freeDSP/freeDSPx-AMP-x4/PARTLIST/basket_mouser.xls

WARENKORB
Dies ist keine Rechnung
Dez 06, 2016 14:13:36
 | Mouser-Nr. | Herst.- Nr. | Hersteller | Kundennummer | Beschreibung | RoHS | Lebenszyklus | Stückzahl | Preis (EUR) | Durchw.: (EUR)
1 | 667-EEU-FC1V101 | EEU-FC1V101 | Panasonic |  | Alu-Elektrolytkondensatoren - verdrahtet 100uF 35V | RoHS-konform |  | 8 | 0,453 € | 3,62 €
2 | 81-GRM18R71E223KA01J | GRM188R71E223KA01J | Murata |  | Kondensator aus mehreren Keramikschichten MLCC - SMD/SMT 0603 0.022uF 25volts X7R 10% | RoHS-konform |  | 8 | 0,094 € | 0,75 €
3 | 81-GCM31CR71H684KA7L | GCM31CR71H684KA37L | Murata |  | Kondensator aus mehreren Keramikschichten MLCC - SMD/SMT 1206 0.68uF 50volts X7R 10% | RoHS-konform | Neu bei Mouser | 8 | 0,415 € | 3,32 €
4 | 81-GRM319R6YA106KA2D | GRM319R6YA106KA12D | Murata |  | Kondensator aus mehreren Keramikschichten MLCC - SMD/SMT 1206 10uF 35volts *Derate Voltage/Temp | RoHS-konform |  | 1 | 0,292 € | 0,29 €
5 | 81-GRM39X104K50D | GRM188R71H104KA93D | Murata |  | Kondensator aus mehreren Keramikschichten MLCC - SMD/SMT 0603 0.1uF 50volts X7R 10% | RoHS-konform |  | 10 | 0,02 € | 0,20 €
6 | 81-GRM31CR70J226KE9L | GRM31CR70J226KE19L | Murata |  | Kondensator aus mehreren Keramikschichten MLCC - SMD/SMT 22uF 6.3Volts 10% | RoHS-konform |  | 1 | 0,472 € | 0,47 €
7 | 81-GRM188R71C105KE5D | GRM188R71C105KE15D | Murata |  | Kondensator aus mehreren Keramikschichten MLCC - SMD/SMT 0603 1uF 16volts X7R 10% | RoHS-konform |  | 16 | 0,032 € | 0,51 €
8 | 621-SBR10E45P5-7 | SBR10E45P5-7 | Diodes Incorporated |  | Schottky Dioden & Gleichrichter 10A SBR 45Vrrm | RoHS-konform | Neues Produkt | 1 | 0,528 € | 0,53 €
9 | 576-5.0SMDJ28CA | 5.0SMDJ28CA | Littelfuse |  | TVS-Dioden - Suppressordioden (Transient Voltage Suppressors) TVS Diode SMC Suf MT | RoHS-konform |  | 1 | 2,07 € | 2,07 €
10 | 771-PMEG6010ER115 | PMEG6010ER,115 | NXP |  | Schottky Dioden & Gleichrichter SCHOTTKY RECT 60V 1 A | RoHS-konform |  | 1 | 0,23 € | 0,23 €
11 | 710-150080RS75000 | 150080RS75000 | Wurth Electronics |  | Standard-LEDs - SMD WL-SMCW SMDMono TpVw Waterclr 0805 Red | RoHS-konform |  | 4 | 0,16 € | 0,64 €
12 | 710-150060GS75000 | 150060GS75000 | Wurth Electronics |  | Standard-LEDs - SMD WL-SMCW SMDMono TpVw Waterclr 0603 Green | RoHS-konform |  | 1 | 0,13 € | 0,13 €
13 | 81-BLM18PG471SN1D | BLM18PG471SN1D | Murata |  | Ferritperlen 470 OHM | RoHS-konform |  | 1 | 0,094 € | 0,09 €
14 | 875-28F0181-1SR-10 | 28F0181-1SR-10 | Laird Technologies |  | Ferritperlen 115ohms 100MHz 10A Broad Band Frequency | RoHS-konform |  | 1 | 0,33 € | 0,33 €
15 | 571-826646-2 | 826646-2 | TE Connectivity |  | Sockel & Kabelgehäuse 2P SINGLE ROW | RoHS-konform |  | 1 | 0,292 € | 0,29 €
16 | 80-L1207C470KPWST | L1207C470KPWST | Kemet |  | Festinduktoren 47uH 10% | RoHS-konform |  | 1 | 0,283 € | 0,28 €
17 | 81-1264EY-150MP3 | 1264EY-150M=P3 | Murata |  | Festinduktoren 15uH 104.4mOhms3.0A +/-20% 6.3x6.3x5.0mm | RoHS-konform | Neues Produkt | 8 | 0,472 € | 3,78 €
18 | 571-796911-2 | 796911-2 | TE Connectivity |  | Feste Anschlussblöcke 2 POS TERMI-BLOK PCB SD WR ENT | RoHS-konform |  | 5 | 0,434 € | 2,17 €
19 | 710-61201621621 | 61201621621 | Wurth Electronics |  | Sockel & Kabelgehäuse WR-BHD 2.54mm Box 16Pin Male Straight | RoHS-konform |  | 1 | 0,54 € | 0,54 €
20 | 71-CRCW0603-1.02K-E3 | CRCW06031K02FKEA | Vishay |  | Dickfilmwiderstände - SMD 1/10watt 1.02Kohms1% 1% | RoHS: Konform durch Ausnahmegenehmigung |  | 1 | 0,094 € | 0,09 €
21 | 71-CRCW0603-3.4K-E3 | CRCW06033K40FKEA | Vishay |  | Dickfilmwiderstände - SMD 1/10watt 3.4Kohms 1% | RoHS: Konform durch Ausnahmegenehmigung |  | 1 | 0,094 € | 0,09 €
22 | 71-CRCW0603-620-E3 | CRCW0603620RFKEA | Vishay |  | Dickfilmwiderstände - SMD 1/10watt 620ohms 1% | RoHS: Konform durch Ausnahmegenehmigung |  | 5 | 0,094 € | 0,47 €
23 | 71-CRCW0603-2.4K-E3 | CRCW06032K40FKEA | Vishay |  | Dickfilmwiderstände - SMD 1/10watt 2.4Kohms 1% | RoHS: Konform durch Ausnahmegenehmigung |  | 8 | 0,094 € | 0,75 €
24 | 71-CRCW0603-100K-E3 | CRCW0603100KFKEA | Vishay |  | Dickfilmwiderstände - SMD 1/10watt 100Kohms 1% | RoHS: Konform durch Ausnahmegenehmigung |  | 4 | 0,094 € | 0,38 €
25 | 71-CRCW0603-22K-E3 | CRCW060322K0FKEA | Vishay |  | Dickfilmwiderstände - SMD 1/10watt 22Kohms 1% | RoHS: Konform durch Ausnahmegenehmigung |  | 3 | 0,094 € | 0,28 €
26 | 652-CAY16-330J4LF | CAY16-330J4LF | Bourns |  | Widerstandnetzwerke u. -Arrays 33ohm 5% Convex 4resistors | RoHS-konform |  | 1 | 0,095 € | 0,10 €
27 | 926-M2841XMKADJLNOPB | LM2841XMK-ADJL/NOPB | Texas Instruments |  | Spannungsregulatoren - Schaltregler 300MA-42V INPUT STEP DOWN DC/DC REG | RoHS-konform |  | 1 | 2,75 € | 2,75 €
28 | 595-TAS5720MRSMT | TAS5720MRSMT | Texas Instruments |  | Audioverstärker Closed Loop I2S Input Amplifier with Power Limiter, PVDDmax of 26.4V 32-VQFN -25 to 85 | RoHS-konform | Neues Produkt | 4 | 5,04 € | 20,16 €
Durch das Absenden Ihrer Bestellung erklären Sie sich mit diesen Geschäftsbedingungen einverstanden. (http://www.mouser.de/saleterms) |  |  |  |  |  |  |  |  | Gesamtwarenkosten: | 45,31 €
Die Preise sind zum angezeigten Datum und zur Uhrzeit reflektiert. |  |  |  |  |  |  |  |  | Versandkosten: | 20,00 €
 |  |  |  |  |  |  |  |  | Versand von Nachlieferungen: | 0,00 €
