freeDSP/freeDSPx-AMP-x4/PARTLIST/link_mouser.txt

http://www.mouser.de/ProjectManager/ProjectDetail.aspx?AccessID=af1cc43262
