freeDSP/freeDSPx-AMP-x4/SOURCES/Schematic/freeDSPx-AMPx4.pdf

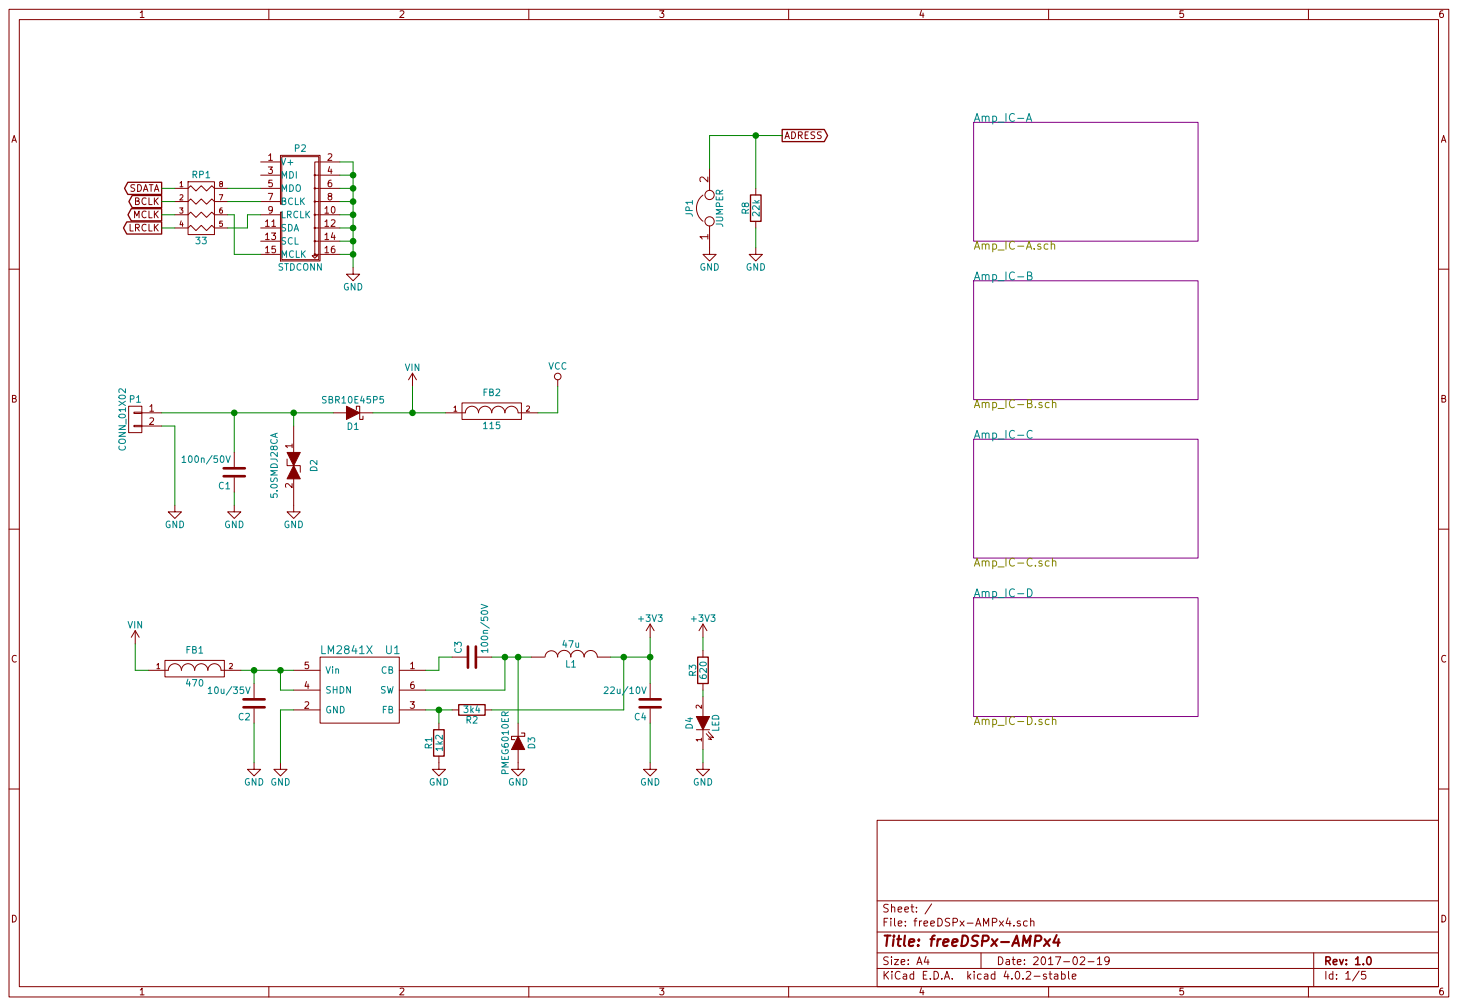
[picture p1: page 1]

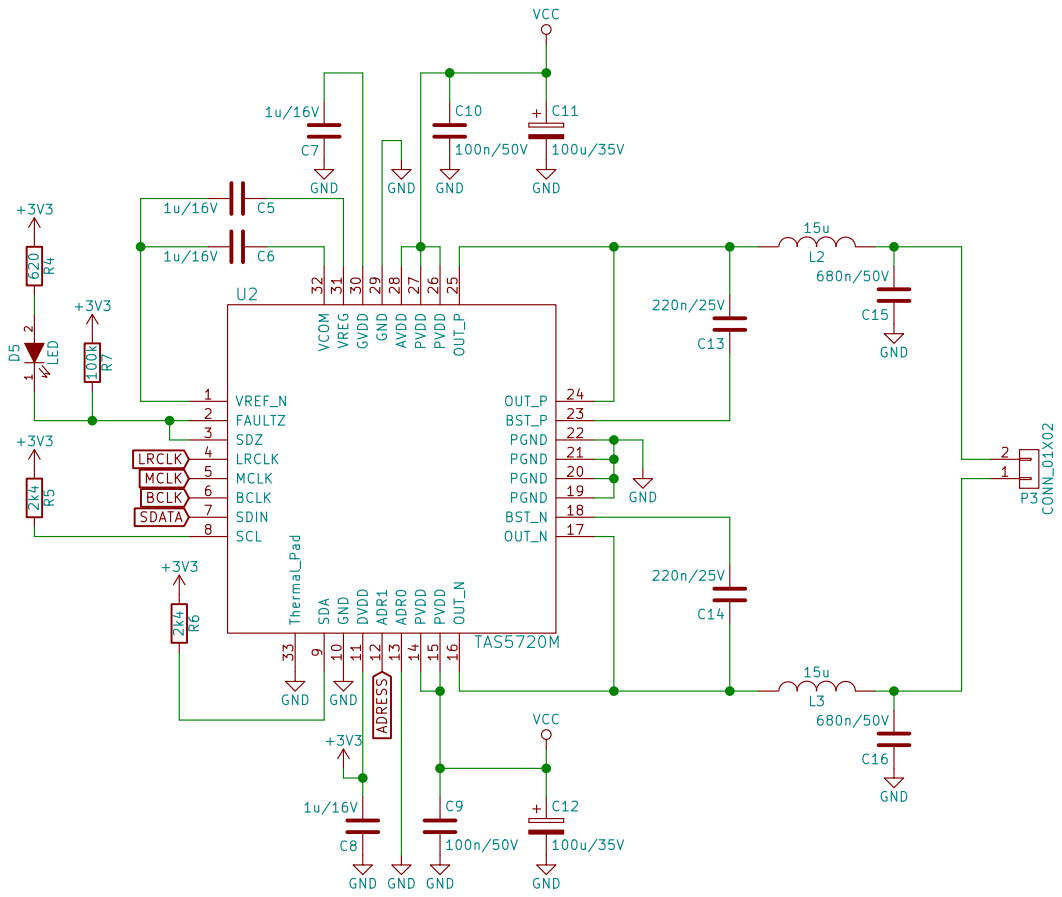
[picture p2: page 2]

9 GND 10 PGND 20 GVDD 30 DVDD 11 PGND 21 VREG 31 ADR1 12 PGND 22 VCOM 32 ADR0 13 BST_P 23 Thermal_Pad 33 PVDD 14 OUT_P 24 PVDD 15 OUT_P 25 OUT_N 16 PVDD 26 OUT_N 17 PVDD 27 BST_N 18 AVDD 28 PGND 19 GND 29 U2 TAS5720M

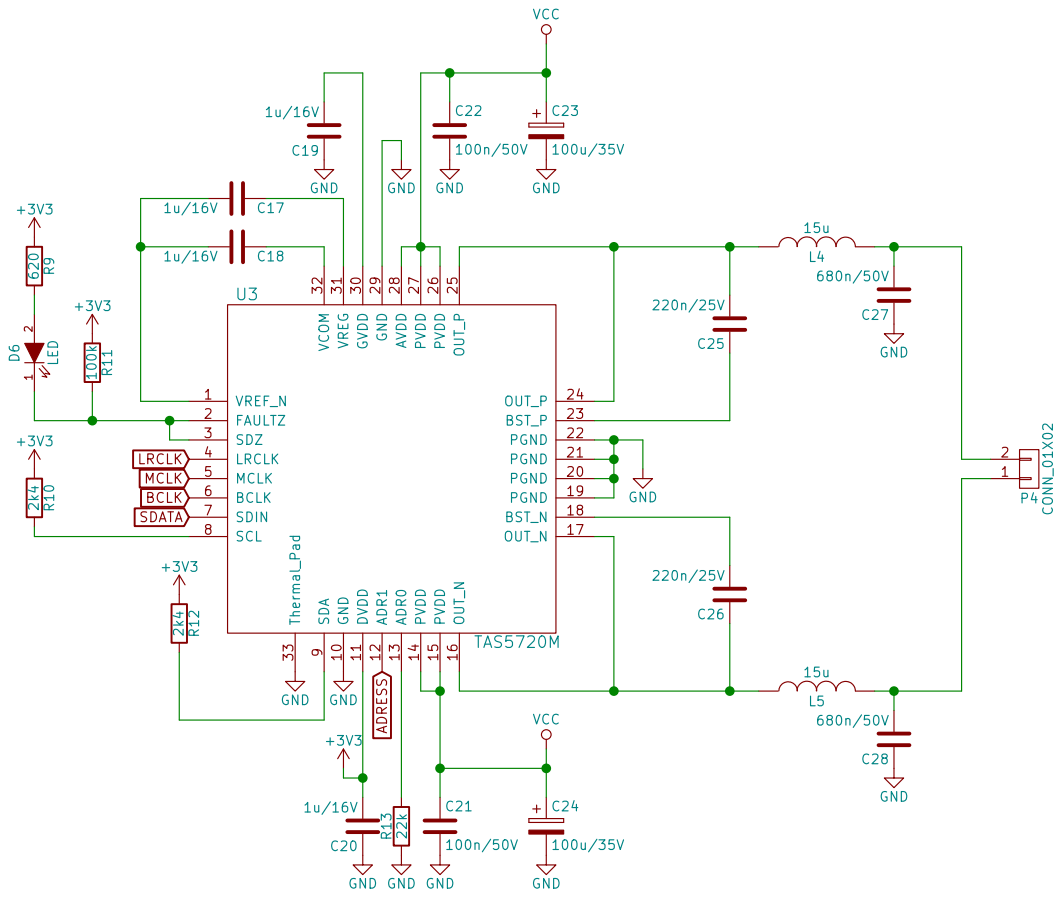
[picture p3: page 3]

9 GND 10 PGND 20 GVDD 30 DVDD 11 PGND 21 VREG 31 ADR1 12 PGND 22 VCOM 32 ADR0 13 BST_P 23 Thermal_Pad 33 PVDD 14 OUT_P 24 PVDD 15 OUT_P 25 OUT_N 16 PVDD 26 OUT_N 17 PVDD 27 BST_N 18 AVDD 28 PGND 19 GND 29 U3 TAS5720M

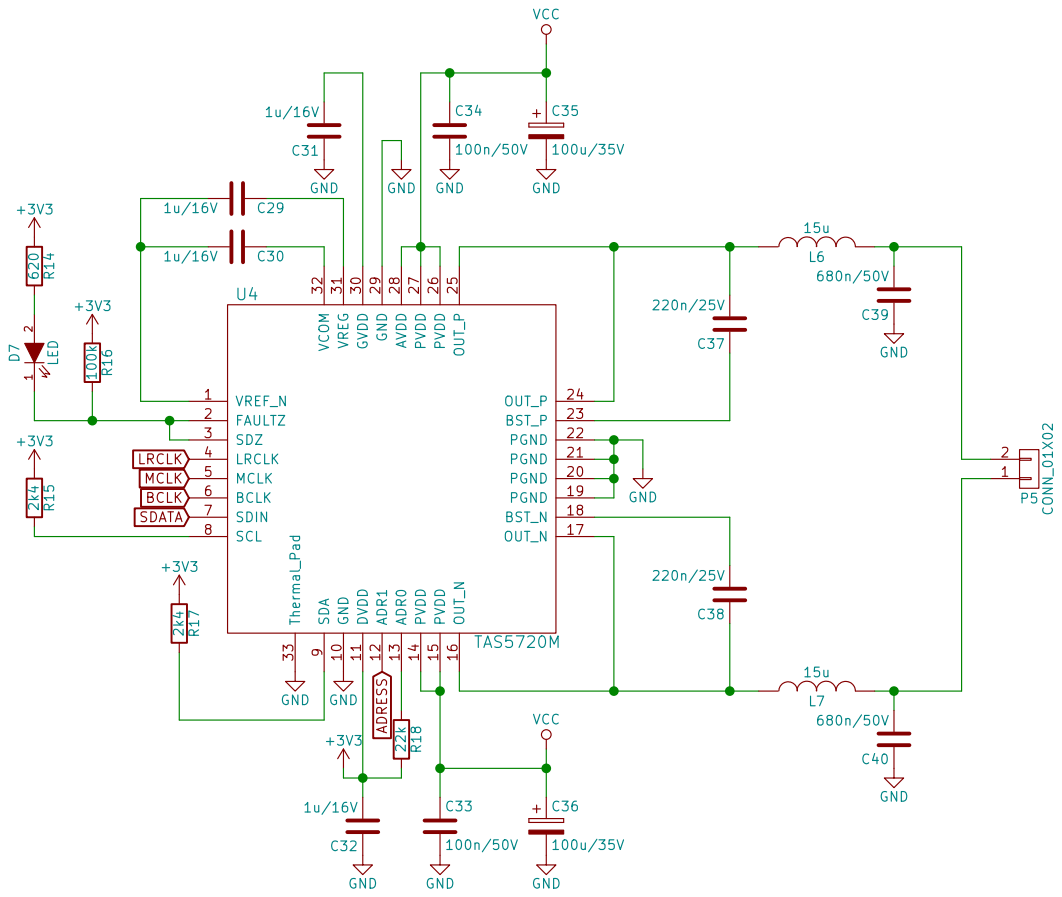
[picture p4: page 4]

9 GND 10 PGND 20 GVDD 30 DVDD 11 PGND 21 VREG 31 ADR1 12 PGND 22 VCOM 32 ADR0 13 BST_P 23 Thermal_Pad 33 PVDD 14 OUT_P 24 PVDD 15 OUT_P 25 OUT_N 16 PVDD 26 OUT_N 17 PVDD 27 BST_N 18 AVDD 28 PGND 19 GND 29 U4 TAS5720M

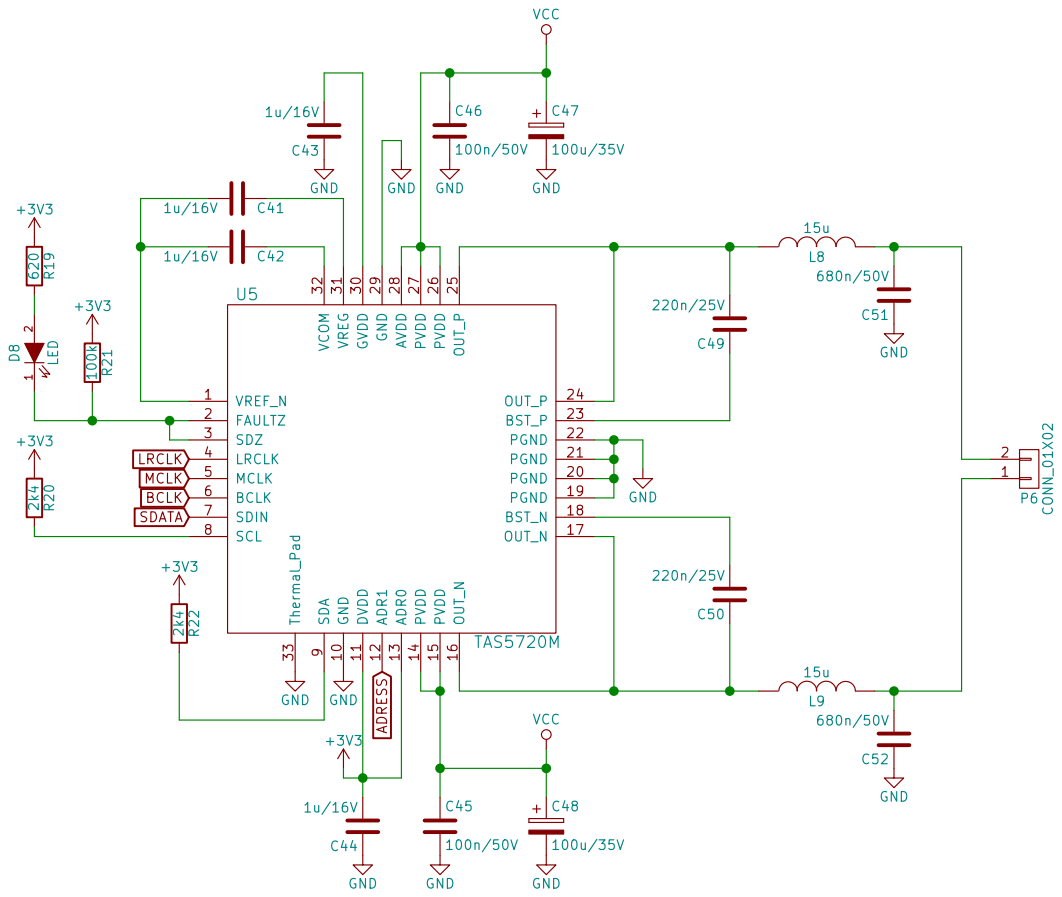
[picture p5: page 5]

9 GND 10 PGND 20 GVDD 30 DVDD 11 PGND 21 VREG 31 ADR1 12 PGND 22 VCOM 32 ADR0 13 BST_P 23 Thermal_Pad 33 PVDD 14 OUT_P 24 PVDD 15 OUT_P 25 OUT_N 16 PVDD 26 OUT_N 17 PVDD 27 BST_N 18 AVDD 28 PGND 19 GND 29 U5 TAS5720M
