freeDSP/freeDSPx-AMP-x4/SOURCES/Kicad/Amp_IC-B.sch

## KiCad design SOURCES/Kicad/Amp_IC-B.sch (2017-02-28)

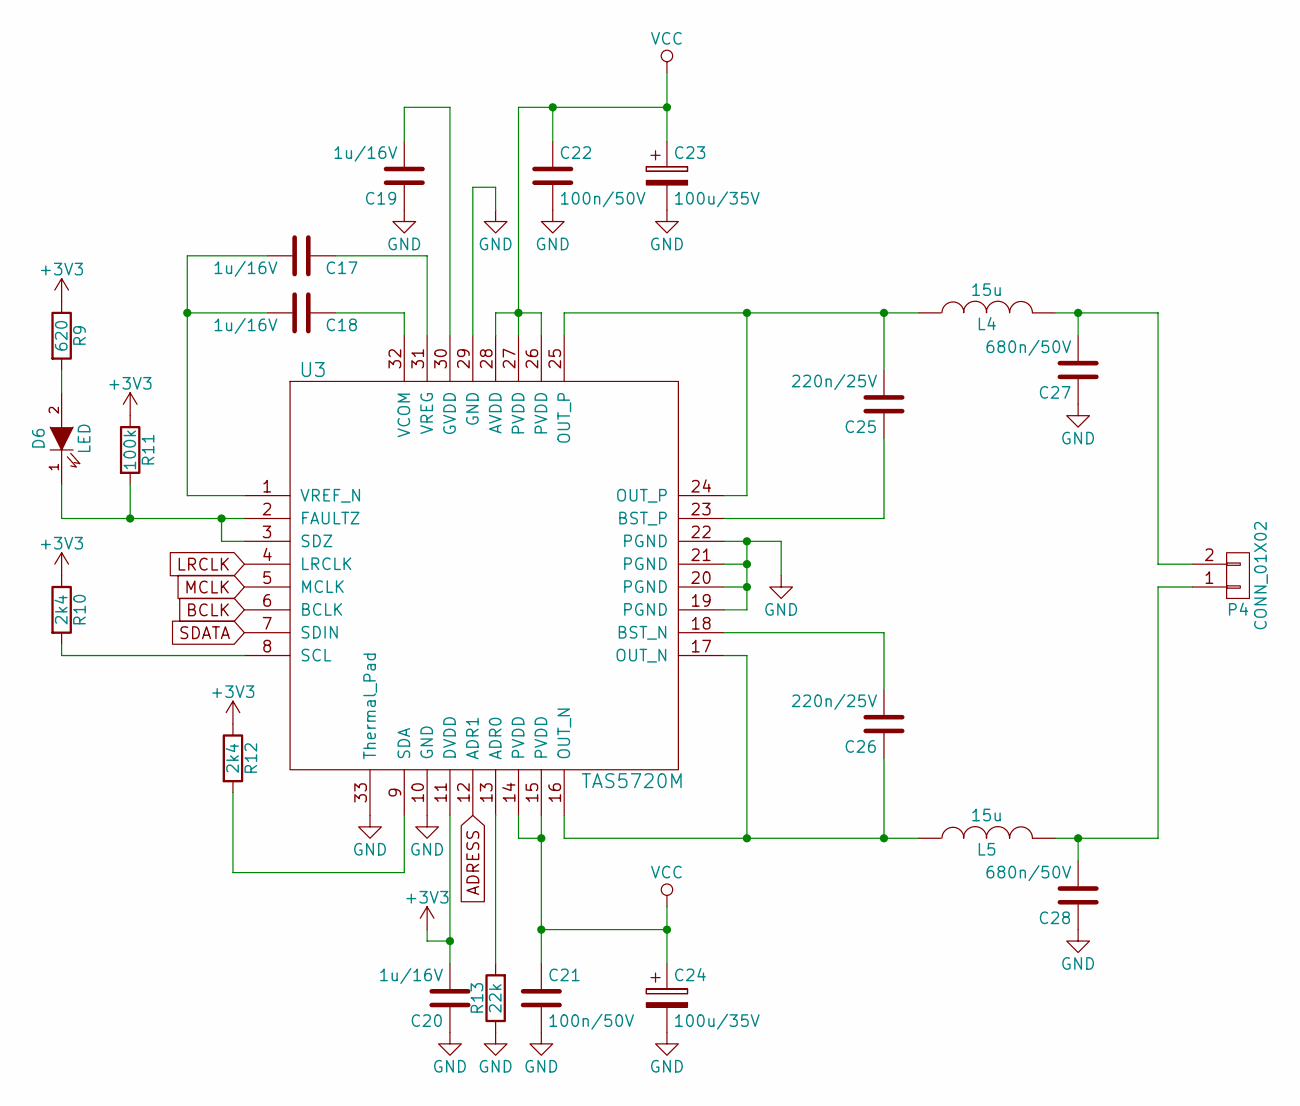
[picture p7: schematic Amp_IC-B.sch]

Parts:
C17, C18, C19, C20: 1u/16V; C_0603; Mouser_Part_No 81-GRM188R71C105KE5D
C21, C22: 100n/50V; C_0603; Mouser_Part_No 81-GRM39X104K50D
C23, C24: 100u/35V; C_Radial_D8_L11.5_P3.5; Mouser_Part_No 667-EEU-FC1V101
C25, C26: 220n/25V; C_0603; Mouser_Part_No 81-GRM18R71E223KA01J
C27, C28: 680n/50V; C_1206; Mouser_Part_No 81-GCM31CR71H684KA7L
D6: LED; C_0603; Mouser_Part_No 710-150080RS75000
L4, L5: 15u; Choke_SMD_6.0x6.0; Mouser_Part_No 81-1264EY-150MP3
P4: CONN_01X02; RIACON101-2; Mouser_Part_No 571-796911-2
R9: 620; R_0603; Mouser_Part_No 71-CRCW0603-620-E3
R10, R12: 2k4; R_0603; Mouser_Part_No 71-CRCW0603-2.4K-E3
R11: 100k; R_0603; Mouser_Part_No 71-CRCW0603-100K-E3
R13: 22k; R_0603; Mouser_Part_No 71-CRCW0603-22K-E3
U3: TAS5720M; VQFN-32_4x4mm_Pitch0.4mm; Mouser_Part_No 595-TAS5720MRSMT

Connections:
+3V3: C20.2, R9.1, R10.1, R11.1, R12.1, U3.11 (DVDD)
ADRESS: U3.12 (ADR1)
BCLK: U3.6 (BCLK)
GND: C19.1, C20.1, C21.2, C22.2, C23.2, C24.2, C27.1, C28.1, R13.1, U3.10 (GND), U3.19 (PGND), U3.20 (PGND), U3.21 (PGND), U3.22 (PGND), U3.29 (GND), U3.33 (Thermal_Pad)
LRCLK: U3.4 (LRCLK)
MCLK: U3.5 (MCLK)
unnamed: C17.1, U3.31 (VREG)
unnamed: C17.2, C18.2, U3.1 (VREF_N)
unnamed: C18.1, U3.32 (VCOM)
unnamed: C19.2, U3.30 (GVDD)
unnamed: C25.1, U3.23 (BST_P)
unnamed: C25.2, L4.1, U3.24 (OUT_P), U3.25 (OUT_P)
unnamed: C26.1, L5.1, U3.16 (OUT_N), U3.17 (OUT_N)
unnamed: C26.2, U3.18 (BST_N)
unnamed: C27.2, L4.2, P4.2
unnamed: C28.2, L5.2, P4.1
unnamed: D6.1 (K), R11.2, U3.2 (FAULTZ), U3.3 (SDZ)
unnamed: D6.2 (A), R9.2
unnamed: R10.2, U3.8 (SCL)
unnamed: R12.2, U3.9 (SDA)
unnamed: R13.2, U3.13 (ADR0)
SDATA: U3.7 (SDIN)
VCC: C21.1, C22.1, C23.1, C24.1, U3.14 (PVDD), U3.15 (PVDD), U3.26 (PVDD), U3.27 (PVDD), U3.28 (AVDD)
