freeDSP/freeDSPx-AMP-x4/SOURCES/Kicad/Amp_IC-D.sch

## KiCad design SOURCES/Kicad/Amp_IC-D.sch (2017-02-28)

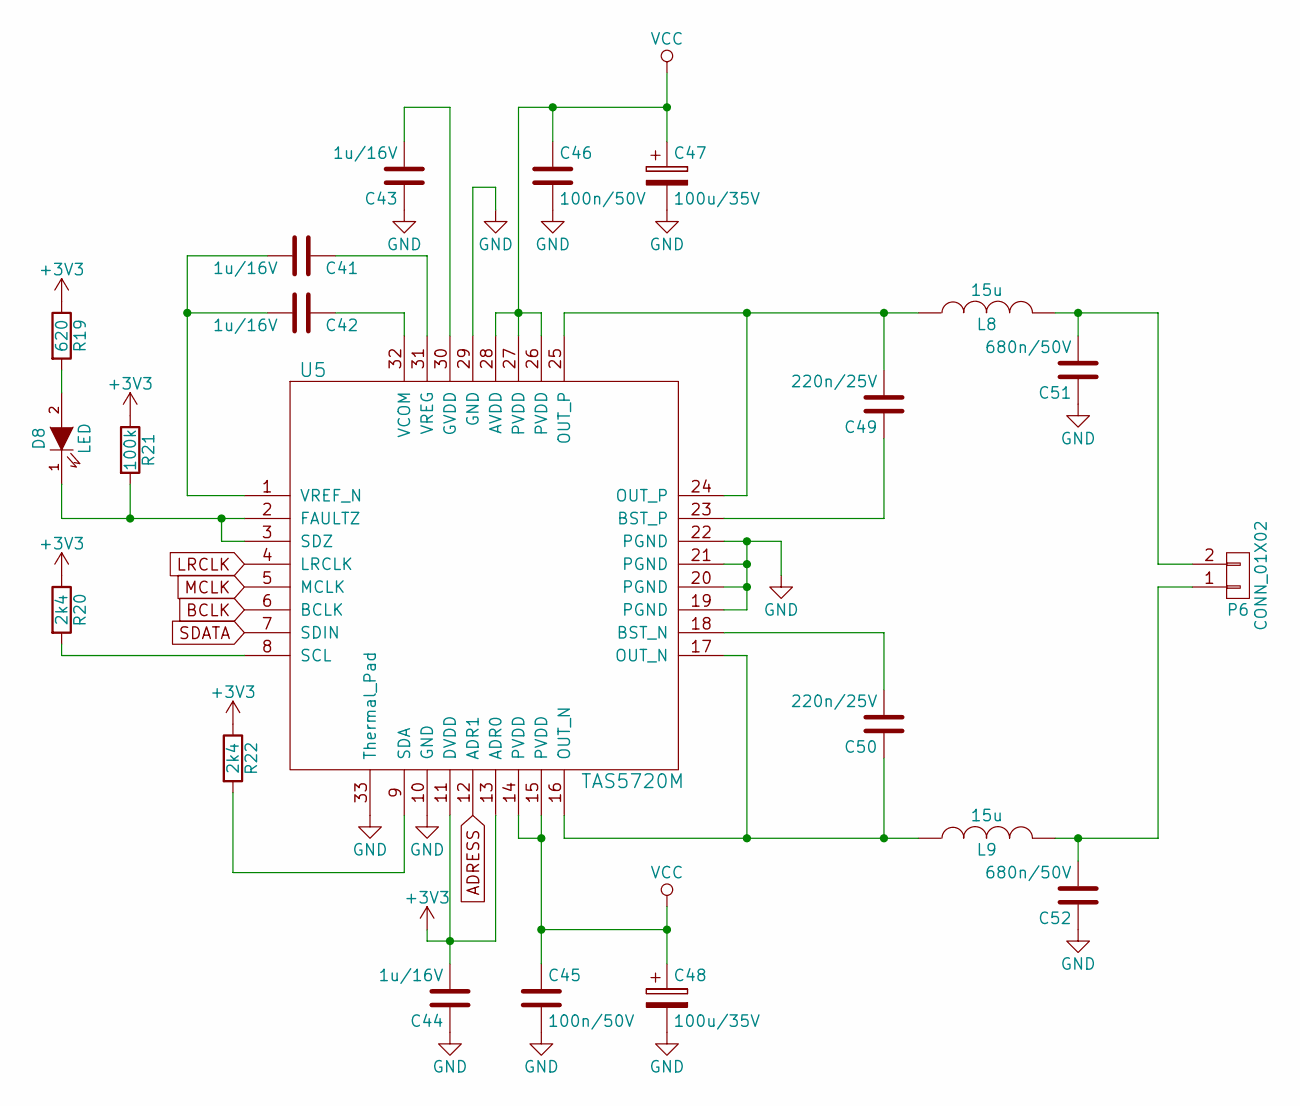
[picture p9: schematic Amp_IC-D.sch]

Parts:
C41, C42, C43, C44: 1u/16V; C_0603; Mouser_Part_No 81-GRM188R71C105KE5D
C45, C46: 100n/50V; C_0603; Mouser_Part_No 81-GRM39X104K50D
C47, C48: 100u/35V; C_Radial_D8_L11.5_P3.5; Mouser_Part_No 667-EEU-FC1V101
C49, C50: 220n/25V; C_0603; Mouser_Part_No 81-GRM18R71E223KA01J
C51, C52: 680n/50V; C_1206; Mouser_Part_No 81-GCM31CR71H684KA7L
D8: LED; C_0603; Mouser_Part_No 710-150080RS75000
L8, L9: 15u; Choke_SMD_6.0x6.0; Mouser_Part_No 81-1264EY-150MP3
P6: CONN_01X02; RIACON101-2; Mouser_Part_No 571-796911-2
R19: 620; R_0603; Mouser_Part_No 71-CRCW0603-620-E3
R20, R22: 2k4; R_0603; Mouser_Part_No 71-CRCW0603-2.4K-E3
R21: 100k; R_0603; Mouser_Part_No 71-CRCW0603-100K-E3
U5: TAS5720M; VQFN-32_4x4mm_Pitch0.4mm; Mouser_Part_No 595-TAS5720MRSMT

Connections:
+3V3: C44.2, R19.1, R20.1, R21.1, R22.1, U5.11 (DVDD), U5.13 (ADR0)
ADRESS: U5.12 (ADR1)
BCLK: U5.6 (BCLK)
GND: C43.1, C44.1, C45.2, C46.2, C47.2, C48.2, C51.1, C52.1, U5.10 (GND), U5.19 (PGND), U5.20 (PGND), U5.21 (PGND), U5.22 (PGND), U5.29 (GND), U5.33 (Thermal_Pad)
LRCLK: U5.4 (LRCLK)
MCLK: U5.5 (MCLK)
unnamed: C41.1, U5.31 (VREG)
unnamed: C41.2, C42.2, U5.1 (VREF_N)
unnamed: C42.1, U5.32 (VCOM)
unnamed: C43.2, U5.30 (GVDD)
unnamed: C49.1, U5.23 (BST_P)
unnamed: C49.2, L8.1, U5.24 (OUT_P), U5.25 (OUT_P)
unnamed: C50.1, L9.1, U5.16 (OUT_N), U5.17 (OUT_N)
unnamed: C50.2, U5.18 (BST_N)
unnamed: C51.2, L8.2, P6.2
unnamed: C52.2, L9.2, P6.1
unnamed: D8.1 (K), R21.2, U5.2 (FAULTZ), U5.3 (SDZ)
unnamed: D8.2 (A), R19.2
unnamed: R20.2, U5.8 (SCL)
unnamed: R22.2, U5.9 (SDA)
SDATA: U5.7 (SDIN)
VCC: C45.1, C46.1, C47.1, C48.1, U5.14 (PVDD), U5.15 (PVDD), U5.26 (PVDD), U5.27 (PVDD), U5.28 (AVDD)
