freeDSP/freeDSPx-AMP-x4/SOURCES/Kicad/freeDSPx-AMPx4.sch

## KiCad design SOURCES/Kicad/freeDSPx-AMPx4.sch (2017-02-28)

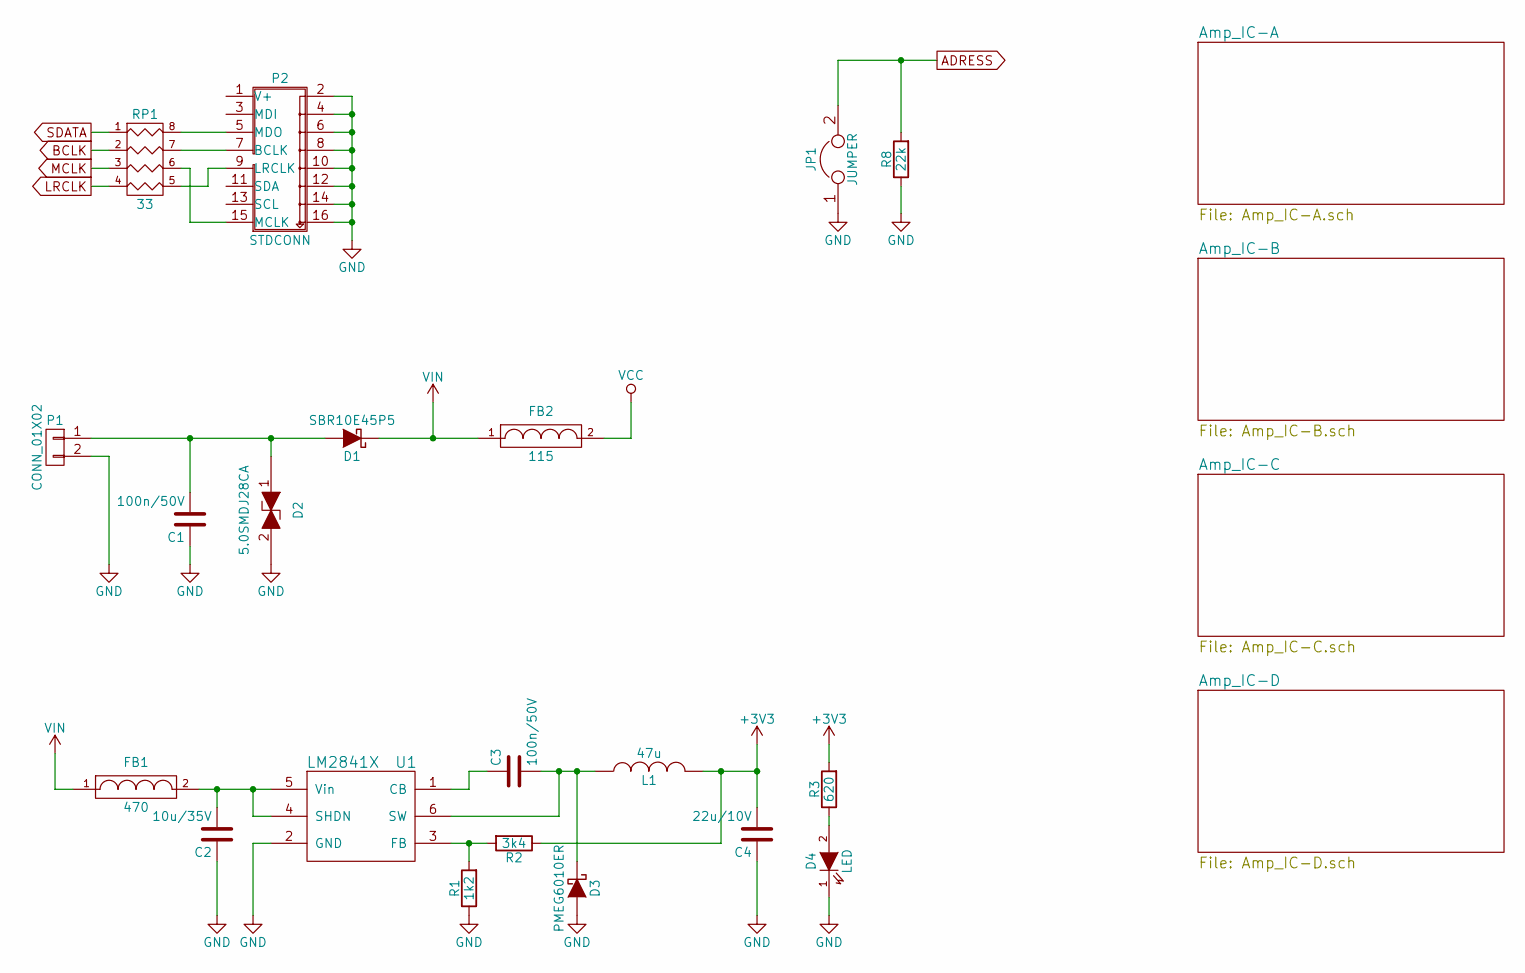
[picture p10: schematic freeDSPx-AMPx4.sch]

Parts:
C1, C3: 100n/50V; C_0603; Mouser_Part_No 81-GRM39X104K50D
C2: 10u/35V; C_1206; Mouser_Part_No 81-GRM319R6YA106KA2D
C4: 22u/10V; C_1206; Mouser_Part_No 81-GRM31CR70J226KE9L
D1: SBR10E45P5; PowerDI5; Mouser_Part_No 621-SBR10E45P5-7
D2: 5.0SMDJ28CA; SMC; Mouser_Part_No 576-5.0SMDJ28CA
D3: PMEG6010ER; SOD-123W; Mouser_Part_No 771-PMEG6010ER115
D4: LED; C_0603; Mouser_Part_No 710-150060GS75000
FB1: 470; C_0603; Mouser_Part_No 81-BLM18PG471SN1D
FB2: 115; C_3312; Mouser_Part_No 875-28F0181-1SR-10
JP1: JUMPER; Pin_Header_Straight_1x02; Mouser_Part_No 571-826646-2
L1: 47u; L_1207; Mouser_Part_No 80-L1207C470KPWST
P1: CONN_01X02; RIACON101-2; Mouser_Part_No 571-796911-2
P2: STDCONN; IDC_Header_Straight_16pins; Mouser_Part_No 710-61201621621
R1: 1k2; R_0603; Mouser_Part_No 71-CRCW0603-1.02K-E3
R2: 3k4; R_0603; Mouser_Part_No 71-CRCW0603-3.4K-E3
R3: 620; R_0603; Mouser_Part_No 71-CRCW0603-620-E3
R8: 22k; R_0603; Mouser_Part_No 71-CRCW0603-22K-E3
RP1: 33; R_Array_Convex_4x0603; Mouser_Part_No 652-CAY16-330J4LF
U1: LM2841X; SOT23-6_1.7x3.0mm_Pitch0.95mm; Mouser_Part_No 926-M2841XMKADJLNOPB

Connections:
+3V3: C4.2, L1.2, R2.1, R3.2
ADRESS: JP1.2, R8.2
BCLK: RP1.2
GND: C1.1, C2.1, C4.1, D2.2, D3.2 (A), D4.1 (K), JP1.1, P1.2, P2.2 (GND), P2.4 (GND), P2.6 (GND), P2.8 (GND), P2.10 (GND), P2.12 (GND), P2.14 (GND), P2.16 (GND), R1.1, R8.1, U1.2 (GND)
LRCLK: RP1.4
MCLK: RP1.3
unnamed: C1.2, D1.2 (A), D2.1, P1.1
unnamed: C2.2, FB1.2, U1.4 (SHDN), U1.5 (Vin)
unnamed: C3.1, U1.1 (CB)
unnamed: C3.2, D3.1 (K), L1.1, U1.6 (SW)
unnamed: D4.2 (A), R3.1
unnamed: P2.5 (MDO), RP1.8 (R1)
unnamed: P2.7 (BCLK), RP1.7 (R2)
unnamed: P2.9 (LRCLK), RP1.5 (R4)
unnamed: P2.15 (MCLK), RP1.6 (R3)
unnamed: R1.2, R2.2, U1.3 (FB)
SDATA: RP1.1
VCC: FB2.2
VIN: D1.1 (K), FB1.1, FB2.1
